jeffglousher/INJS2065-Technic-Case/print/retention/coupons-receivers.3mf

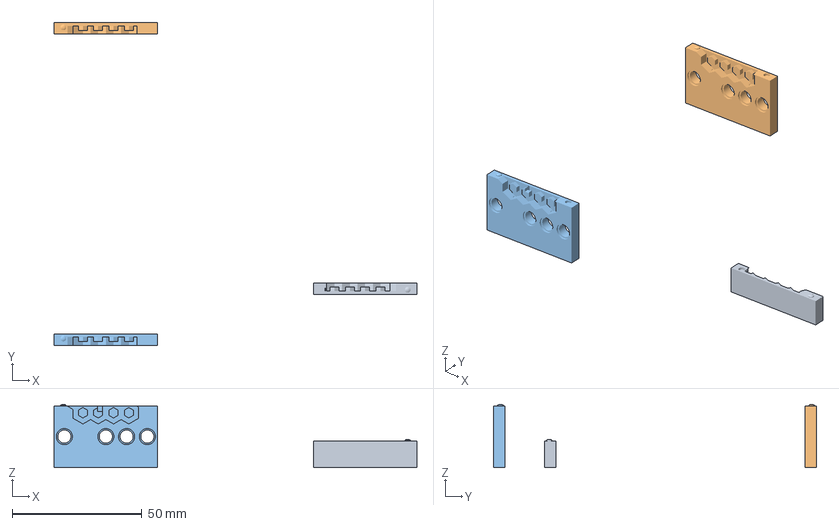
[picture p14: CAD file, 2026-11-08]
print/retention/coupons-receivers.3mf
140.0 x 124.4 x 24.4 mm
1 Lower registered rail
2 Control upper rail
3 Latch upper rail A and B
