jeffglousher/INJS2065-Technic-Case/print/servo-holder.3mf

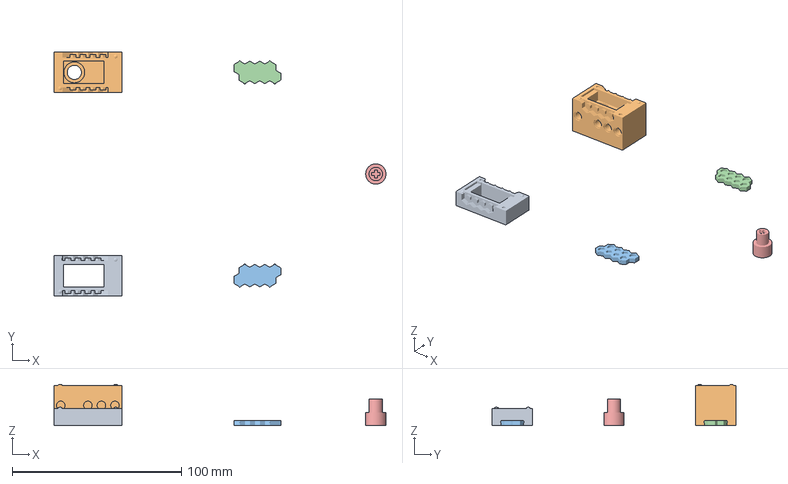
[picture p15: CAD file, 2026-11-06]
print/servo-holder.3mf
196.0 x 144.0 x 24.4 mm
Lower clamshell
Upper clamshell
Clip +Y
Clip -Y
Output hub
