jeffglousher/INJS2065-Technic-Case/print/retention/coupons-clips.3mf

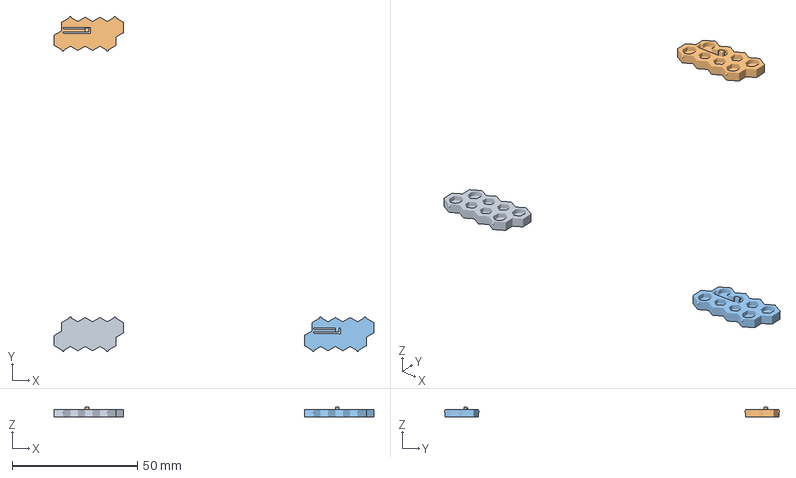
[picture p16: CAD file, 2026-11-07]
print/retention/coupons-clips.3mf
127.8 x 133.9 x 4.05 mm
4 Control clip
5 Latch A 1.2 mm tongue
6 Latch B 1.0 mm tongue
