jeffglousher/INJS2065-Technic-Case/(list of files, cad)

Other CAD files:
print/retention/holder-latch-A.3mf
