jeffglousher/INJS2065-Technic-Case/(commit log)

2026-09-19 Park v16.8 session: clip print failed; body structure issues open.
    Includes gen scripts, nbcad, audits, print 3MFs, review shots (v16.2-v16.8), Cad Bot skills copies, and SESSION_HANDOVER.md for the next session.
    [BuckleClipYM.3mf, BuckleClipYP.3mf, ClamshellA.3mf, ClamshellB.3mf, INJS2065-v16.8-printed.3mf, OutputHub.3mf]
2026-09-20 Replace version folders with single design/ tree at v16.23.
    Drops v16.2-v16.8 directories; history retains them. Current Codex v16.23 becomes design/. Updates handover for print-in-progress and tooling debt.
    [BuckleClipYM.3mf, BuckleClipYP.3mf, ClamshellA.3mf, ClamshellB.3mf, INJS2065-v16.8-printed.3mf, OutputHub.3mf]
2026-09-20 v16.24: inside bearing insert with outer retaining lip; thicker hub ledge.
    Replace the v16.23 front Ø12.3 through-face pocket (bearing sat in the outer
    pocket) with a seat-width pocket and Ø8.5 face poke-out so the closed clamshell
    retains bearing OD. Hub flange thickens to 2.0 mm then steps to Ø8.5 neck;
    Technic cross and side-sleeve throat unchanged. Live JSONC replay + mesh
    section validation under design/shots/.
2026-09-20 v16.25: one-direction assembly into upper_cover (reject both-halves-around).
    Continuous Ø12.3 insert path from split into ClamshellB bearing pocket with
    Ø8.5 face lip; side Technic blind 8.2 mm (through-sleeve wall sacrificed).
2026-09-20 v16.26: constant OutputHub OD until servo flange step.
    Merge flange→neck fillet and free-standing bearing riser lip into one
    continuous Ø11.2 column; keep journal and small inner stop under bearing.
2026-09-20 v16.26: note live CAD unavailable; keep numeric PASS + schematic shot path.
2026-09-20 v16.27: center open-C clips 50/50 in clamshell slot (equal X gaps).
    Restore SLOT_HALF = SPINE_HALF + 0.10 so each clip has 0.10 mm clearance
    both sides of the blue pocket (was 0.04 total interference / biased look).
    Clip and pocket share CLIP_X=0; hub constant OD and friction open-C unchanged.
2026-09-20 v16.28: FDM GD&T fits — journal 7.90 clr into BRG_ID, tight clip X press, nest Z clr.
    JOURNAL 7.90 (0.10 diametral / 0.05 radial into ID 8.0); clip X equal 0.03/side
    interference centered; BODY_CLR 0.18, TAB_Z_CLR 0.18, TAB_CLR 0.15. Keep hub
    OD Ø11.2 and one-direction upper assembly. Numeric PASS; MCP IFC not connected.
2026-09-20 v16.29: center open-C clips vertically (Z) in clamshell slot; wider+shorter.
    Jeff clarification: 50/50 in slot means Z along mating face, not X (v16.27
    wrong axis). mid-clip == mid-slot; CLIP_XW 7.40; span Z 11.60; X press 0.08
    total kept. Journal/nest/hub OD/one-direction/friction open-C unchanged.
2026-09-20 docs: align VERSION convention with CAD ops
2026-09-20 v16.32: strength dome apex into solid (+Z); JSONC-first SoT tip.
    horn_dome_flip: QX180 [1,0,0,0] → identity [0,0,0,1]; z=spline_depth unchanged
    (base on blind floor, apex into column — not bump into horn cavity). Prune gen_v16_31.py
    and unversioned JSONC; SoT is design_v16_32.nbcad.jsonc only.
2026-09-20 v16.33: Technic CROSS_DEPTH 8→10 into mid column; keep dome into solid.
    Slot bottom local z 7.7→5.7 (+2 mm intrusion). Extrude 10.6. Strength dome
    unchanged (identity rot, apex +Z). SoT design_v16_33.nbcad.jsonc only.
2026-09-20 v16.34: uniform Technic 8.0 depths; shared CLIP↔POCKET; fix side bore face select.
    Lock side/top/CROSS_DEPTH on 8.0 module (revert hub cross 10→8, slot z0 7.7).
    Reselect Technic side faces by normal+origin Y=±12 so both ±X bores open.
    Rebuild pocket from CLIP envelope ± named CLR — no orphan cavity above clip.
2026-09-20 v16.34: clarify JSONC document name for uniform Technic 8.0 cut.
2026-09-20 v16.35: tighten journal Ø7.94 and face hole Ø8.15 for adapter force constraint.
    PETG 0.4/0.2 FDM: diametral clr journal↔BRG_ID 0.10→0.06; face↔journal 0.60→0.21. Keep BRG pocket/OD, Technic 8.0, lead-in/tip rings, dome into solid.
2026-09-20 v16.36: fix hub entry chamfer radius for Ø7.94; drop brittle clip entry chamfers.
    Blank-doc replay stopped ~826/831 on chamfer \$select. clip_yp/ym_entry used brittle /key edge:N; hub_entries still matched r=3.95 (Ø7.90) after journal tighten to Ø7.94. Drop cosmetic clip entry chamfers; keep hub 0.2mm with r=3.97. Journal 7.94 / face 8.15 / Technic 8.0 unchanged.
2026-09-20 v16.37: encapsulate both servo tabs (+X shell→24); denser 8-hole face Technic grid.
    Grow shell_x to [-12,24] with far nest [16.95,21] and 3 mm tip wall; cav_x to 17.4; far_end_open=false. Face Technic 4→8 on 8 mm pitch (add x=16 and x=0 at y=±8). Keep OutputHub mates and Technic depth 8.0.
2026-09-21 v16.38: Technic envelope shell[-16,32]×[±16]; drop face (0,±8); add (24,±8); denser green side pins.
    Grow both X ends to module margins (8 mm past outermost holes) and Y cheeks to ±16; retarget face Technic off bearing; add side pins on ClamshellB only. CLIP/hub mates untouched.
2026-09-21 v16.39: tight Technic floor shell[-12,28]×[±12]; restore external clips.
    Cut oversized v16.38 margins to half-pitch 4 mm edge; shell_y back to ±12 so clip pockets straddle outer ±Y again. Face Technic unchanged (no 0,±8); green side pins through-class; BuckleClip geom and hub mates untouched.
2026-09-21 v16.41: green-centered longer clip (drop middle tooth); remove side Technic x=0.
    Lengthen BuckleClip onto ClamshellB envelope CLIP_Z[16.45,41.55] center 29.0; keep open-C + solid_mirror -Y; xbar0+xbar2 only. Drop cb_side x=0 shaft bores; extend B pocket/lands.
2026-09-21 docs: align working branch name to tip VERSION (cad-bot/v16.41-current).
2026-09-21 v16.42: recenter clip on clamshell join/mate (split_z); keep 2 teeth + no x=0 side holes.
    Restore CLIP_Z=[12.45,24.05] center 18.25 equal ±5.8 A/B from v16.40; keep v16.41 xbar1 removal and no side Technic at x=0; keep solid_mirror -Y.
2026-09-21 v16.43: drop x=0 side pin recesses; widen mate-centered open-C clip
2026-09-21 v16.44: remove inner xbar lips; AM hex clamp faces + land pockets
    Drop cyp_xbar0/2 joins; keep open-C outer-edge lip. Add flat-top hex
    bosses (FF 2.8, depth 1.2 mm = former lip engage) on clip clamp face and
    matching land receptacles (FF 3.1, depth 1.35) on ±Y A/B spines. Envelope
    unchanged (split_z clip, solid_mirror -Y).
2026-09-21 v16.44: hex multi-body select — take all 6 after multi-profile extrude
    Replay failed at land_hex_yp_a_tmp (selector expected 1, found 6).
2026-09-21 v16.45: honeycomb wall lattice on clamp face (reject solid hex bosses)
    Pad 1.2 mm on clip inner face then cut open pointy-top hex cells (wall 1.2 mm,
    3 perimeters @0.4 nozzle; FF 2.8; rot 0° vertical flats // Z). Matching land
    openings +0.2 CLR. Keep open-C outer lip; no inner xbars; solid_mirror −Y.
2026-09-21 v16.45: fix −Y land honeycomb extrude flip; harden Thunder TIP runner
    Root-cause of pin@426 stop was mid-edit UI ("Finish the current edit"), not
    circle JSONC (identical to v16.44 through step 912). Land −Y openings now
    use solid_extrude flip=true to match v16.44. Thunder scripts Escape/Finish
    Sketch, expand Load-from-path, default TIP, fail-fast on Stopped, require
    Complete N/N with N>=1000. Regenerated review explode ±14mm.
2026-09-21 v16.46: land honeycomb cutters into land (not outside bosses)
    v16.45 placed land hex tools mostly outside spine_inner_y±10.4 so they
    read as solid bosses. +Y now Y[9.05,10.4], −Y Y[-10.4,-9.05]. Clip
    pad+open-cell wall lattice unchanged.
2026-09-22 v16.47: open-C hex-wall rings, drop the full-face pad
    The v16.46 cyp_hpad sheet closed the center of the retainer. Keep cyp_out
    minus cyp_open, and join eight 1.2 mm pointy-top hex rings to that C.
    Clamshell A/B get matching +0.2 mm grooves split at z=18.25. Side Technic
    holes are unchanged.
2026-09-22 v16.48: coplanar clamp face — lips and hex tip together
    v16.47 stuck hex rings on the recessed spine shelf (tips at Y=9.2 on
    face Y=10.4) while lips tipped at Y=9.05. Move hex tips to the lip tip
    plane, match depth to the spine, cut centers through the spine, and
    update A/B land grooves to the same clamp face. Side Technic unchanged.
2026-09-23 v16.49: single-sketch hex pattern (out join + in cut)
    Replace per-cell hex sketches with one outer-pattern join and one
    inner-pattern cut for the clip, and the same doctrine per land A/B half.
    Nested rings in one sketch do not form on overlapping hexes. Geometry
    numbers stay at the v16.48 coplanar clamp face.
2026-09-23 fix: guard Technic side holes by their own steps
    The clip validator hashed from the first cb_side id through the first
    land id, so the v16.49 hex rewrite failed a check the holes did not
    change. Hash the eight solid_hole steps and their face selects against
    the v16.48 baseline instead.
2026-09-23 v16.50: merge hex walls into the clip tip
    v16.49 emptied the C mouth and joined a separate hex lattice onto it, so the pattern read as a plate. Cut the outer hex out of the mouth tool and cut only the remainder from the blank; inner hexes cut that same body. Lips and walls share the Y=9.05 face. Side Technic unchanged.
2026-09-26 Publish v16.51 clamp-face hex as the servo holder source of truth.
    The keep-tool and hole cutters now land on the blank, and T3 Code uses this checkout directly.
2026-09-26 v16.52: cover the clip face with blind hex walls.
    The honeycomb fills the clamp face and stops at the spine instead of cutting through the clip.
2026-09-27 v16.58: checkpoint one bearing bore, a clear cavity wall, and named build steps.
2026-10-05 Consolidate accepted detent CAD and deduplicate identical history
2026-10-06 Archive detent research and verify four-corner compliance
    [clip-173.step, current.step]
2026-10-07 Verify detent flank engagement against fresh CAD renderings
2026-10-07 Update PETG Basic estimates and verify native material slicing
2026-10-07 Blend detent corner reliefs and rounded hidden receiving seats
    Preserve full hex walls and wall minima; repeat PETG Basic screening and native X2D slicing with exploded and OCCT section evidence.
    [clip-fine.3mf, clip-fine.stl, current.step, housing.step, lower-fine.3mf, lower-fine.stl, upper-fine.3mf, upper-fine.stl]
2026-10-08 Prepare complete five-part X2D PETG print project
    [assembly-petg.3mf]
2026-10-08 Document native hub socket sections and toolpath check
2026-10-08 Compare servo-side hub tabs with garden auger pilot
    [auger-servo-mouth.json, current-servo-mouth.json]
2026-10-08 Replace accidental hub tabs with compact friction-fit servo socket
    [assembly-petg-friction-hub.3mf, hub-fine.stl, hub.step, servo-mouth.json]
2026-10-08 Strengthen output hub print profile and verify socket spacing
    [assembly-petg-hub-quality.3mf]
2026-10-08 Record full CAD and PETG print-readiness review
2026-10-08 Save named assembly views and validated sequential PETG candidates
    [assembly-petg-sequential-clip-quality.3mf, assembly-petg-sequential-no-brim.3mf]
2026-10-08 Measure hex underside bevels against native CAD and PETG toolpaths
2026-10-08 Bevel hex post undersides from their roots for progressive PETG printing
    [assembly-petg-root-bevel.3mf]
2026-10-08 Keep detent wall relief while restoring flat clip pocket floors
    [assembly-petg-flat-clip-base.3mf]
2026-10-09 Record printed clip retention failure and paired toolpath diagnosis
2026-10-09 Retune clip locating fit and detent seats with PETG calibration coupon
    [assembly-fit-candidate.3mf, current.step, retention-coupon.3mf]
2026-10-10 Correct retention contact model and register full-shell fit test
    [registered-receivers.3mf]
2026-10-10 Prepare PETG print decision report and full assembly plate
    [assembly-petg-review.3mf]
2026-10-10 Validate Bambu GUI loading and explicit plate print sequence
    [assembly-petg-review.3mf, registered-receivers.3mf]
2026-10-10 Flip output hub servo rim down and validate support-free PETG slice
    [flipped-auto.3mf, flipped-no-support.3mf]
2026-10-10 Tune hub-only support-free roof bridging and compare native bridge modes
    [assembly-petg-bridge-tuned.3mf]
2026-10-10 Restore hex undersides and increment detent and rotary clearance fits
    [assembly-petg-incremental-fit.3mf, registered-receivers.3mf]
2026-10-10 Add localized PETG supports for full housing hex posts
    [assembly-petg-local-hex-supports.3mf, comparison-gap-016.3mf]
2026-10-10 Consolidate current CAD, print projects and design evidence
    [assembly-fit-candidate.3mf, assembly-petg-bridge-tuned.3mf, assembly-petg-flat-clip-base.3mf, assembly-petg-friction-hub.3mf, assembly-petg-hub-quality.3mf, assembly-petg-incremental-fit.3mf, assembly-petg-review.3mf, assembly-petg-root-bevel.3mf]
2026-10-11 Verify current PETG print projects and consolidate inspection report
2026-10-11 Prepare support-free PETG projects and verify native slices
    [assembly-petg.3mf, fit-test-petg.3mf]
2026-10-11 Localize Technic rail print quality and validate saved Bambu projects
    [assembly-petg.3mf, fit-test-petg.3mf]
2026-10-11 Validate print modifier placement and consolidate reviewed delivery evidence
2026-10-11 Explain servo holder and show complete assembled and exploded CAD
2026-10-15 Preserve user-modified hub orientation print project
    [flipped-no-support.3mf]
2026-11-06 Add slicer candidate removing end-wall modifier splits
    [assembly-uniform-shells.3mf]
2026-11-06 Review all servo holder parts and document confirmation-print readiness
2026-11-06 Present servo holder with an auger-style README and mesh gallery
2026-11-06 Call out the servo and bearing in a clear bill of materials
2026-11-06 Remove superseded content and consolidate the current servo holder project
    [assembly-petg.3mf, assembly-uniform-shells.3mf, fit-test-petg.3mf, flipped-no-support.3mf, servo-holder.3mf]
2026-11-07 Add printed release latch and registered retention coupons
    [coupons-clips.3mf, coupons-receivers.3mf, holder-latch-A.3mf]
2026-11-07 Standardize holder project on Limo CAD naming
2026-11-08 Add small outside brims to receiver coupons
    [coupons-receivers.3mf]
